tororo009/LR-hasegawa/LR課題2_報告資料.pptx

## LR課題2 クロックドコンパレータ＆ラッチ

穗刈成晃、長谷川達也

## Slide 2

アルバイト内容
２．クロックドコンパレータ＆ラッチ
TOOL：回路設計⇒Xschem、シミュレーション⇒NGSPICE
目標仕様：判定速度：10MHz
SPICEモデル：OSU035 (課題で使用したモデル)、抵抗とキャパシタは、R,CでOK
納期：9月2日のWEB会議で説明
担当者：長谷川さん、穂刈さん
質問事項は、DISCORDでお願いします。
不明点は、ChartGPTに聞いてもよいです。

【入力・出力信号情報】
VDD:3.3V±10%
inp/inm:0V～VDDのアナログ値
clk: VIL=VDDx0.2, VIH=VDD*0.8, trise=tfall=1ns, tcycle=100ns
en:VIL=VDD*0.2, VIH=VDD*0.8, trise=tfall=1ns, 100KHz
out:VOL=VDD*0.2, VOH=VDD*0.6, tplh=10ns, tphl=10ns
VSS:0V

inp
inm
clk
en

VDD(3.3V)

コンパレータ

VSS(0V)

out

inp>inm

inp<inm

inp>inm

inp<inm

inp
inm
clk
en
out

tcycle

不定

tplh

tphl

## 回路図

コンパレータ

ラッチ

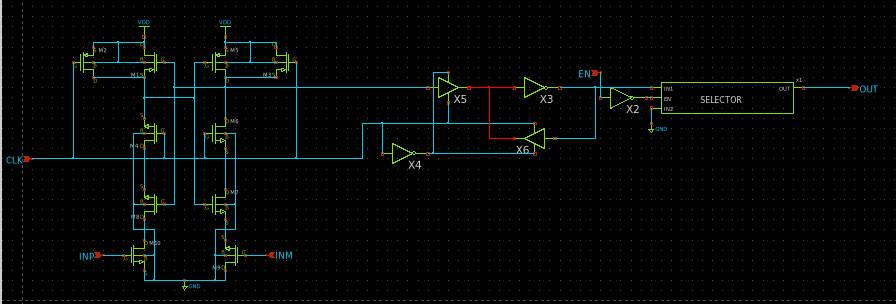
[picture p15: figure]

## 波形

INP>INM

INM>INP

INP>INM

INM>INP

INP>INM

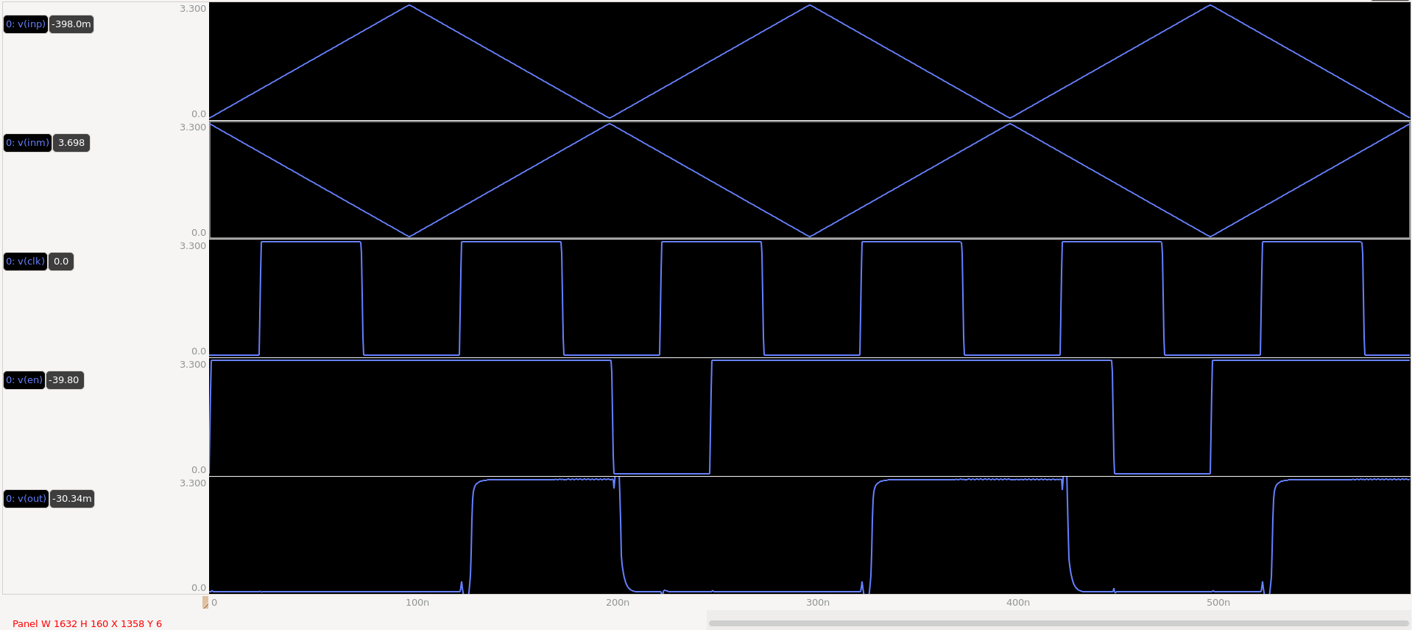
[picture p16: figure]

V(INP)

V(INM)

V(CLK)

V(EN)

V(OUT)

## OUTの遅延時間（tphl, tplh）

【コマンド】
meas TRAN tplh TRIG CLK VAL=1.65 RISE=2 TARG OUT VAL=1.65 RISE=1
meas TRAN tphlen TRIG EN VAL=1.75 FALL=1 TARG OUT VAL=1.75 FALL=1
meas TRAN tphl TRIG CLK VAL=1.65 RISE=5 TARG OUT VAL=1.65 FALL=2

1. CLK RISE, OUT RISE
2. EN FALL , OUT FALL
3. CLK RISE, OUT FALL

【結果】

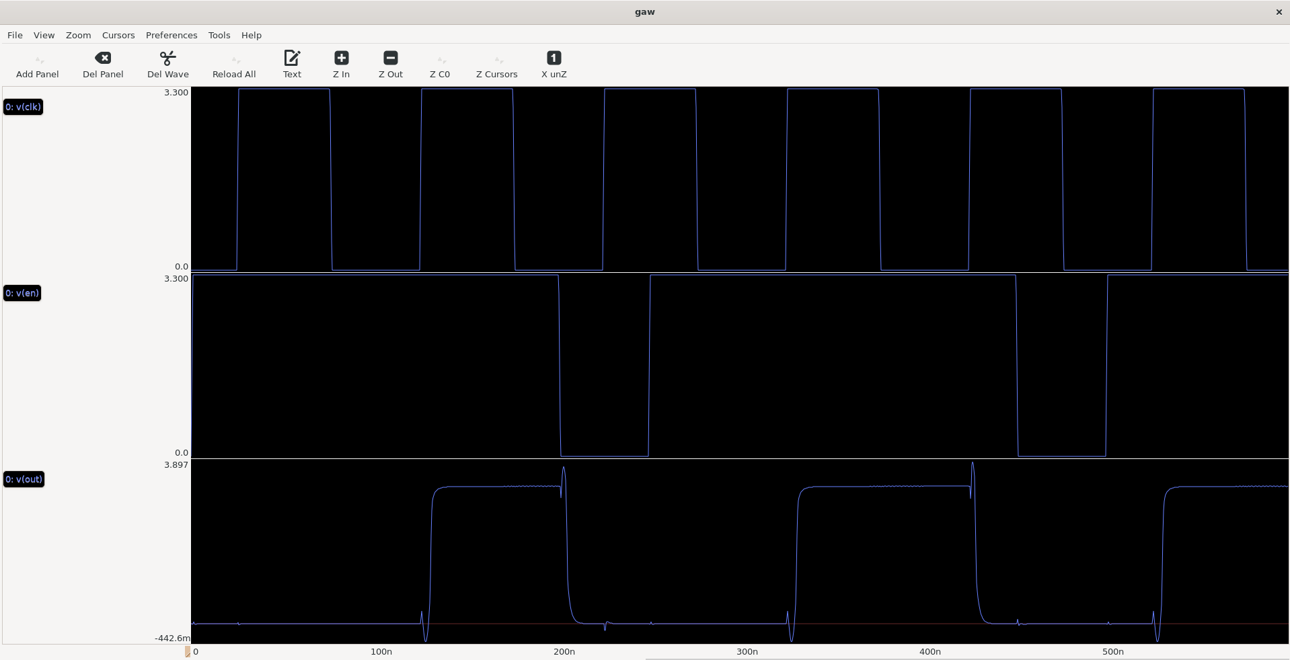
[picture p17: figure]

①

②

③

1. 約 5.57ns
2. 約 4.17ns
3. 約 3.59ns

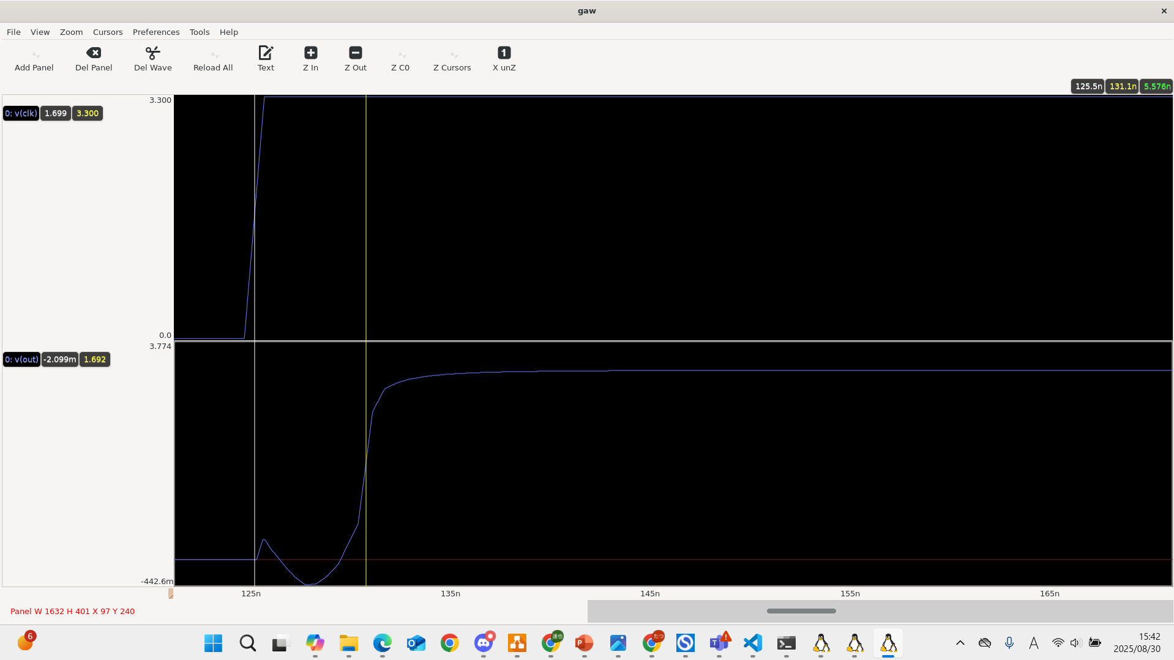
[picture p18: figure]

①

V(CLK)

V(EN)

V(OUT)

## 平均消費電流

- meas TRAN Iavg AVG I(VVDD)

約33.6[uA]

## 回路図（前の状態を保存するver.）

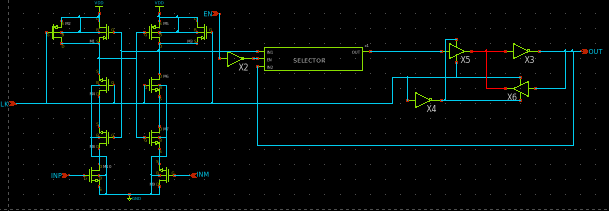
[picture p19: figure]

## 波形

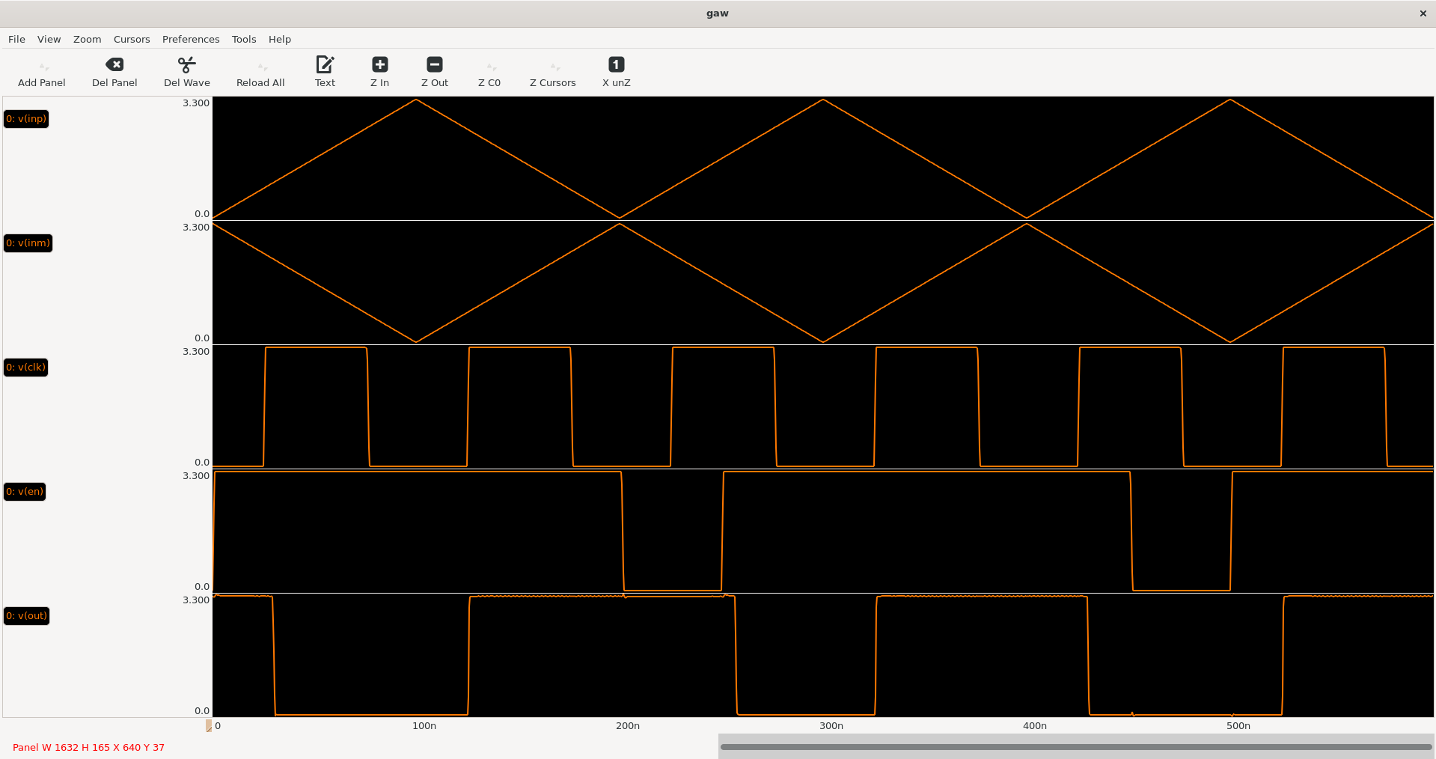
[picture p20: figure]
