tororo009/LR-hasegawa/(commit log)

2025-07-23 07/23 done
    [2NAND.sch, 2NOR.sch]
2025-08-26 Latch回路
    [2NANDENLR.sch, 2NANDENTEST.sch, 2NANDLR.sch, 2NANDTEST.sch, DLATCHENLR.sch, DLATCHLR.sch]
2025-08-26 比較回路実験
    [COMP.sch]
2025-08-27 課題１遅延測定
    [2NAND.sch, 2NOR.sch]
2025-08-30 比較回路、ラッチ回路設計
    [CLOCKEDINVERTER.sch, DLATCHLR.sch, INVERTER.sch, INVERTERDFF.sch, INVERTERDLATCH.sch, SELECTOR.sch]
2025-08-30 遅延時間、平均消費電力
    [clocked_comparatorDF.sch, clocked_comparatorDF2.sch]
2025-08-30 報告作成
2025-10-01 ラッチ、比較回路test
    [2NANDLR.sch, CLOCKEDINVERTER.sch, INVERTER.sch, NAND2.sch, SELECTOR.sch, Sense_Amp.sch, Wide-swing_clocked_comparatortest.sch, clksrlatch copy.sch]
2025-10-07 latch回路改善
    [2NANDLR.sch, CLOCKEDINVERTER.sch, INVERTER.sch, INVERTER_MIN.sch, INVTESTS.sch, NAND2.sch, NOR2.sch, SELECTOR.sch]
2025-10-07 報告書フィードバックを受けて追記
2025-10-15 Latch修正、遅延測定
    [INVERTER18.sch, INVERTER3.sch, INVERTER9.sch, INVTESTS.sch, NAND2.sch, NOR2.sch, clksrlatch.sch]
2026-01-26 1月時点の作業内容
    [INVERTER13.sch, clksrlatchrst.sch, clksrlatchrst2.sch, clksrlatchrst3.sch, clksrlatchrst4.sch, clksrlatchrst5.sch]
2026-02-20 readme更新
    [INVERTER.sch]
2026-03-31 Refactor directory
    [2NAND.sch, 2NOR.sch, INVTESTS.sch, NAND2_INV13927citizen.sch, Sense_Amp.sch, Wide-swing_clocked_comparator.sch, Wide-swing_clocked_comparatortest.sch, clkdlatch copy.sch]
